bklemencz/LN2544_2ch_CWW/DOC/LN2544_2ch_CWW_PCB_3D_TOP.JPG

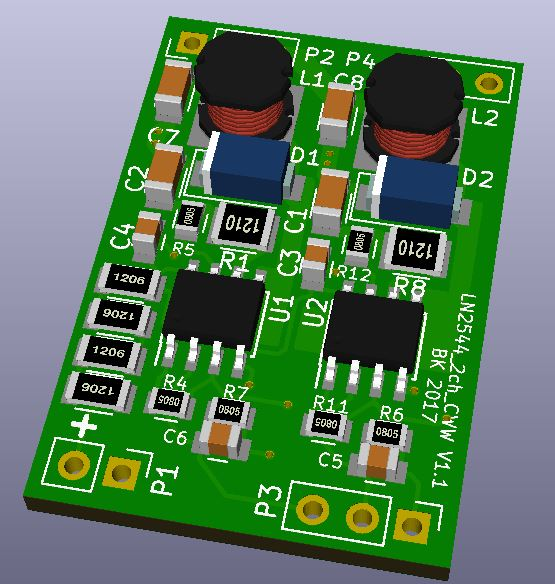
DOC/LN2544_2ch_CWW_PCB_3D_TOP.JPG
