bklemencz/LN2544_2ch_CWW/DOC/LN_2544_2_CH_Common_Positive_Driver_Schematic.pdf

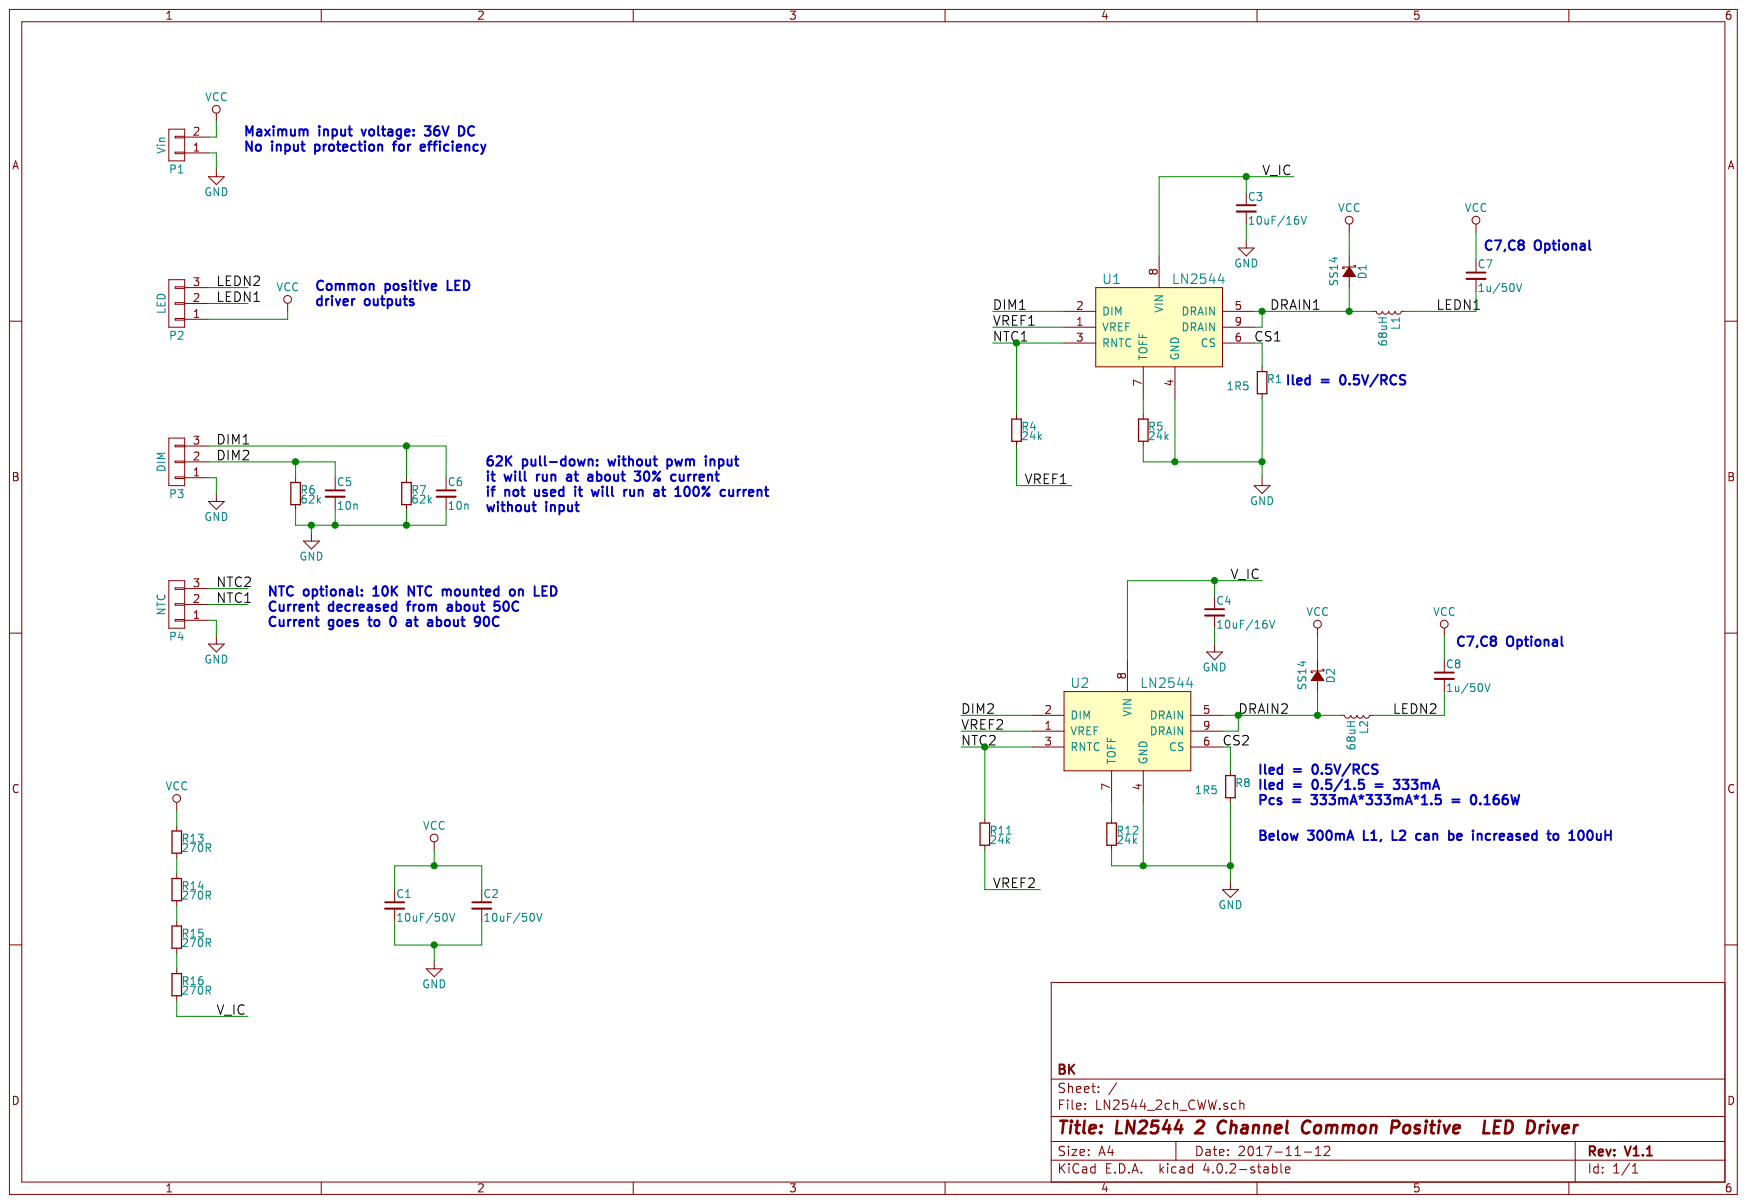
[picture p3: page 1]
