bklemencz/LN2544_2ch_CWW/LN2544_2ch_CWW.kicad_pcb

## KiCad design LN2544_2ch_CWW.kicad_pcb (2017-11-12)

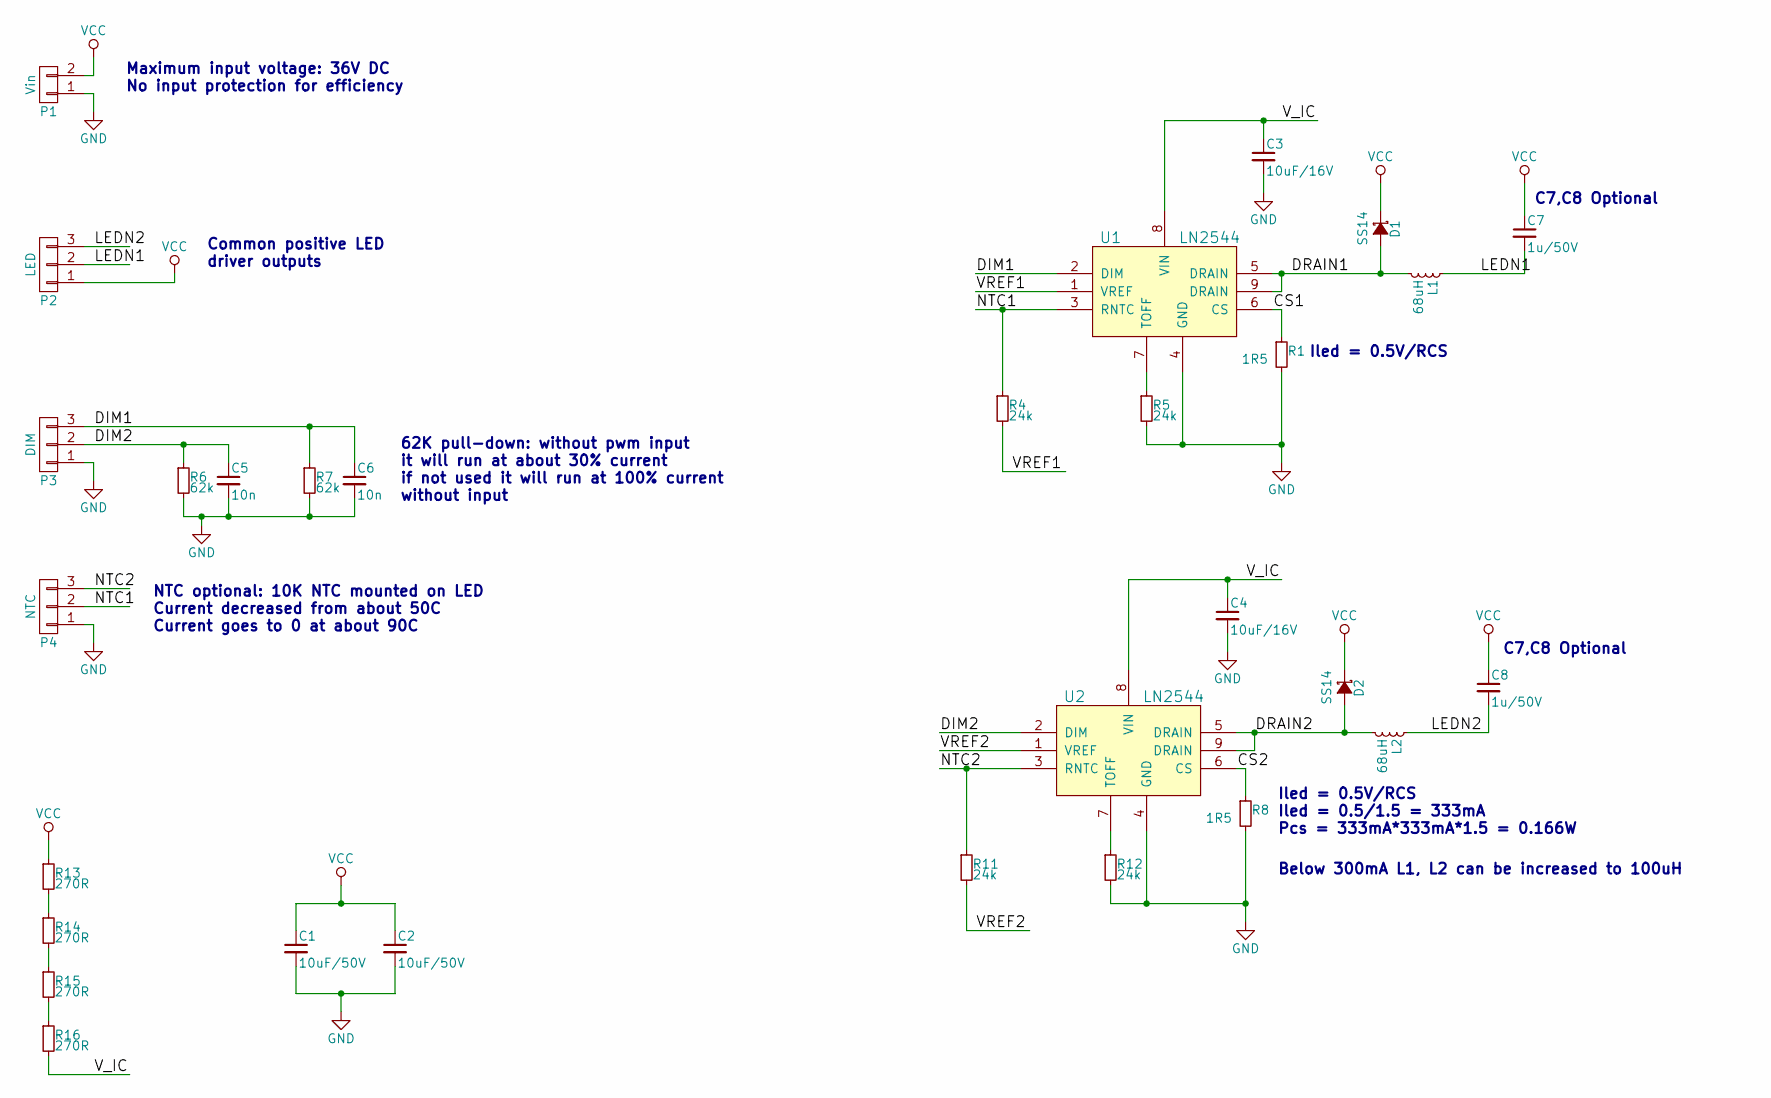
[picture p4: schematic LN2544_2ch_CWW.sch, LN2544 2 Channel Common Positive LED Driver]

Parts:
C1, C2: 10uF/50V; C_1206
C3, C4: 10uF/16V; C_0805
C5, C6: 10n; C_0805
C7, C8: 1u/50V; C_1206
D1, D2: SS14; D_SMA
L1, L2: 68uH; IND_SMD_CD54
P1: Vin; Pin_Header_Straight_1x02_Pitch2.54mm
P2: LED; Pin_Header_Straight_1x03_Pitch2.54mm
P3: DIM; Pin_Header_Straight_1x03_Pitch2.54mm
P4: NTC; Pin_Header_Straight_1x03_Pitch2.54mm
R1, R8: 1R5; R_1210
R4, R5, R11, R12: 24k; R_0805
R6, R7: 62k; R_0805
R13, R14, R15, R16: 270R; R_1206
U1, U2: LN2544; SOIC-8-1EP_3.9x4.9mm_Pitch1.27mm

Connections:
/CS1: R1.1, U1.6 (CS)
/CS2: R8.1, U2.6 (CS)
/DIM1: C6.1, P3.3, R7.1, U1.2 (DIM)
/DIM2: C5.1, P3.2, R6.1, U2.2 (DIM)
/DRAIN1: D1.2 (A), L1.2, U1.5 (DRAIN), U1.9 (DRAIN)
/DRAIN2: D2.2 (A), L2.2, U2.5 (DRAIN), U2.9 (DRAIN)
/LEDN1: C7.2, L1.1, P2.2
/LEDN2: C8.2, L2.1, P2.3
/NTC1: P4.2, R4.1, U1.3 (RNTC)
/NTC2: P4.3, R11.1, U2.3 (RNTC)
/VREF1: R4.2, U1.1 (VREF)
/VREF2: R11.2, U2.1 (VREF)
/V_IC: C3.1, C4.1, R16.2, U1.8 (VIN), U2.8 (VIN)
GND: C1.2, C2.2, C3.2, C4.2, C5.2, C6.2, P1.1, P3.1, P4.1, R1.2, R5.2, R6.2, R7.2, R8.2, R12.2, U1.4 (GND), U2.4 (GND)
unnamed: R5.1, U1.7 (TOFF)
unnamed: R12.1, U2.7 (TOFF)
unnamed: R13.2, R14.1
unnamed: R14.2, R15.1
unnamed: R15.2, R16.1
VCC: C1.1, C2.1, C7.1, C8.1, D1.1 (K), D2.1 (K), P1.2, P2.1, R13.1

Notes on the sheet:
Iled = 0.5V/RCS
Iled = 0.5V/RCS Iled = 0.5/1.5 = 333mA Pcs = 333mA*333mA*1.5 = 0.166W
C7,C8 Optional
62K pull-down: without pwm input it will run at about 30% current if not used it will run at 100% current without input
Common positive LED driver outputs
NTC optional: 10K NTC mounted on LED Current decreased from about 50C Current goes to 0 at about 90C
Maximum input voltage: 36V DC No input protection for efficiency
Below 300mA L1, L2 can be increased to 100uH

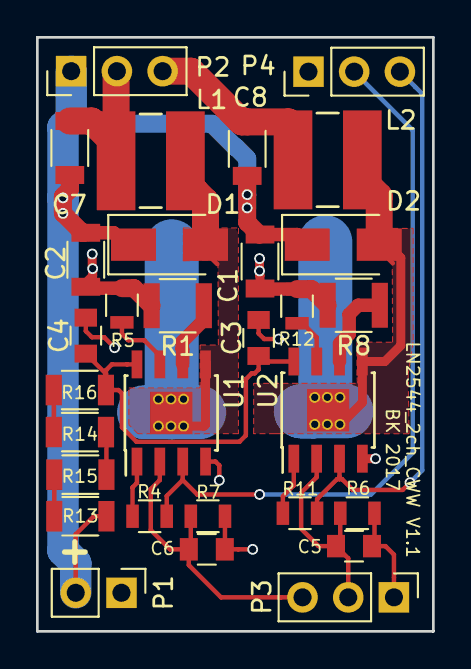
[picture p5: board LN2544_2ch_CWW.kicad_pcb from above]

Board: 2 copper layers, 22.0 x 33.0 mm, 30 parts (0 on the bottom side), 20 nets.
