bklemencz/LN2544_2ch_CWW/(commit log)

2017-06-21 PCB Update
    [LN2544_2ch_CWW.kicad_pcb, _saved_LN2544_2ch_CWW.sch]
2017-06-22 Gerber Out
    [LN2544_2ch_CWW-B.Cu.gbl, LN2544_2ch_CWW-B.Mask.gbs, LN2544_2ch_CWW-B.SilkS.gbo, LN2544_2ch_CWW-Edge.Cuts.gm1, LN2544_2ch_CWW-F.Cu.gtl, LN2544_2ch_CWW-F.Mask.gts, LN2544_2ch_CWW-F.SilkS.gto, LN2544_2ch_CWW-drl_map.gbr]
2017-11-12 V1.1 Update
    [LN2544_2ch_CWW-B.Cu.gbl, LN2544_2ch_CWW-B.Mask.gbs, LN2544_2ch_CWW-B.SilkS.gbo, LN2544_2ch_CWW-Edge.Cuts.gm1, LN2544_2ch_CWW-F.Cu.gtl, LN2544_2ch_CWW-F.Mask.gts, LN2544_2ch_CWW-F.Paste.gtp, LN2544_2ch_CWW-F.SilkS.gto]
2017-11-12 Upd 1.1
    [LN2544_2ch_CWW-B.Cu.gbl, LN2544_2ch_CWW-B.Mask.gbs, LN2544_2ch_CWW-B.SilkS.gbo, LN2544_2ch_CWW-Edge.Cuts.gm1, LN2544_2ch_CWW-F.Cu.gtl, LN2544_2ch_CWW-F.Mask.gts, LN2544_2ch_CWW-F.Paste.gtp, LN2544_2ch_CWW-F.SilkS.gto]
2017-11-12 V1.1 Gerber Update
    [LN2544_2ch_CWW-B.Cu.gbl, LN2544_2ch_CWW-B.Mask.gbs, LN2544_2ch_CWW-B.SilkS.gbo, LN2544_2ch_CWW-Edge.Cuts.gm1, LN2544_2ch_CWW-F.Cu.gtl, LN2544_2ch_CWW-F.Mask.gts, LN2544_2ch_CWW-F.SilkS.gto, LN2544_2ch_CWW-drl_map.gbr]
